jampez77/motor_blind/(list of files, drawings)

Other design files:
files/motor_blind.fzz
