jampez77/motor_blind/(commit log)

2020-10-16 Inital Release
    LED status indicator
    * Solid light = No WiFi connection
    * Flashing Light = no MQTT connection
    * No light = connection established
    ArduinoOTA for wireless code updates.
    Added MQTT config on boot to integrate seamlessly with Home Assistant.
    [motor_blind.fzz]
2021-02-15 Update to enforce JSON config
    Created `mqttName` variable so only a single change is required to create a new device in HA.
2021-02-16 Further work on multiple instances
    Tweaked topics and devices names/IDs so each instance appears as separate device in HA.
    Increase JSON memory allocation by 50 characters to allow for larger device name.
    Updated variables for MQTT server to be more specific and allow port to be changed.
    Version bump to 1.1.1
2021-03-03 Finalised work on WiFiManager
    All relevant variables now updating to new values when required.
    Moved MQTT topics so they're defined in `setup` using the `deviceId`.
    Added `WiFiManager` so project can be setup without code changes.
    Renamed setup switches in HA to more descriptive names.
    Updated readme and docs to include new setup and config process.
2021-03-03 Fix for motor stalling
    updated readme with info about bin file.
    updated .gitignore
    [motor_blind.ino]
2021-03-07 Added new entities
    Added Reset Limits & WiFi AP entities.
    Fixed bug that would stop motors moving sometimes.
    [My_Helper.h, motor_blind.ino]
